shzhhw-lgtm/HINK-5.83EPD/bigclock/IMG_20261107_204027.jpg

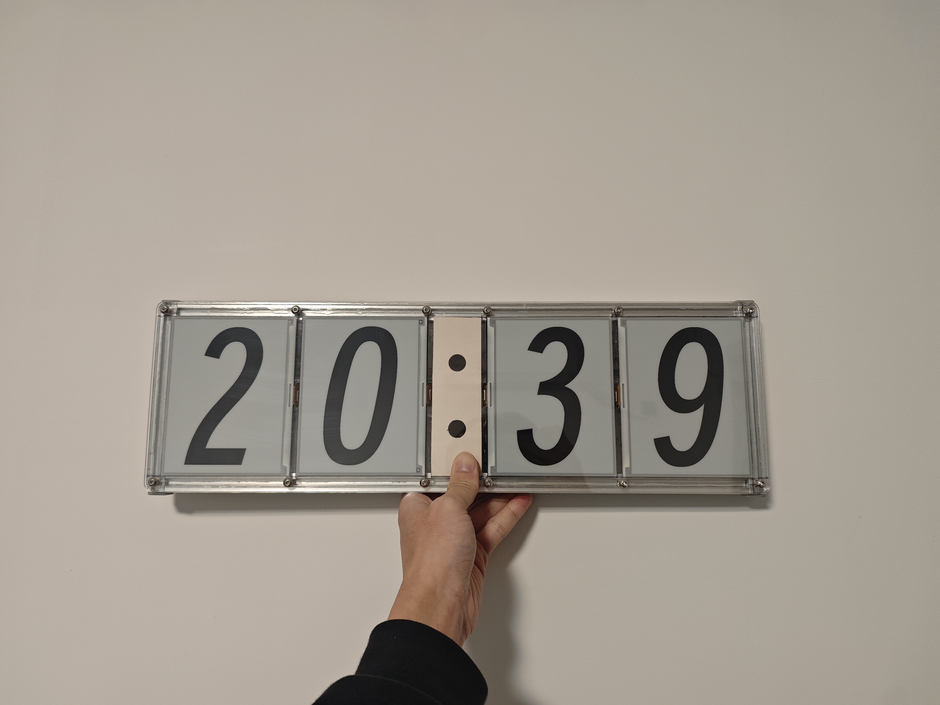
bigclock/IMG_20261107_204027.jpg
