shzhhw-lgtm/HINK-5.83EPD/UC8179_EPD/PARAMETERS.md

# UC8179 可调参数总表（基于 UC8179 手册 + 本屏 OTP）

> 配合 `examples/04_ParamLab` 使用。所有参数都能在运行时改，不需要重烧 OTP。
> 表格里的“OTP 默认”是 `src/UC8179_PanelProfile.h` 里这份 OTP 的值。

---

## 1. 一句话结论

**能改的**：波形档 TR0~TR7、VCOM_DC、VDH/VDL/VDHR、VGH/VGL、帧率、CDI、TCON、
EVS、BTST、PWS、LVSEL、温度偏移、单/双平面、方向、边框 LUT。

**不能改的**：OTP 里烧死的波形表本身（可以整体选哪一档，或整体换成寄存器 LUT），
面板玻璃的极性，OTP 内容（一次性的）。

---

## 2. TR 波形档（最值得先测）

芯片在每次刷新时按温度从 OTP 里选 TR0~TR7。用 `TSFIX=1 + TSSET` 可以强制选任意一档：

| 档位 | 强制温度码 | 适用温度 | 帧率 | VDH/VDL | VCOM_DC | VGH/VGL | 备注 |
|---|---:|---|---:|---|---|---|---|
| TR0 | `0x05` | ≤5°C | 50Hz | ±15.0V | -1.00V | ±20V | 冷 |
| TR1 | `0x0A` | ≤10°C | 50Hz | ±15.0V | -1.00V | ±20V | |
| TR2 | `0x0F` | ≤15°C | 50Hz | ±15.0V | -1.00V | ±20V | |
| TR3 | `0x14` | ≤20°C | 50Hz | ±15.0V | -1.00V | ±20V | |
| TR4 | `0x1E` | ≤30°C | **60Hz** | ±15.0V | -1.00V | ±20V | 常用快速档 |
| TR5 | `0x50` | ≤80°C | **70Hz** | ±15.0V | -1.00V | ±20V | 最快 |
| TR6 | `0x5A` | ≤90°C | 50Hz | ±15.0V | **-2.00V** | ±20V | KWE=0x0A6 |
| TR7 | `0x7F` | ≤127°C | 50Hz | ±15.0V | **-2.00V** | ±20V | 常用高质量档 |

API：

```cpp
epd.setWaveformGear(0..7);     // 直接选 TR0~TR7
epd.setTemperatureForce(0x1E); // 原始 TSSET
epd.setTemperatureAuto();      // 取消强制，回到自动分档
epd.setRefreshMode(UC8179_EPD::REFRESH_QUALITY); // = TR7
```

> TR6/TR7 的 VCOM 是 -2.0V，所以换档时对比度会跟着变，这是 OTP 设计好的，不是 bug。
> 测的时候要连同 VCOM 一起看。

---

## 3. 全部可调寄存器

| 参数 | 命令/寄存器 | 位 | 取值范围 | OTP 默认 | 影响 | 风险 |
|---|---|---|---|---|---|---|
| LUT 来源 | PSR `0x00` | D5 | 0=OTP，1=寄存器 | 0 | 改 1 必须自己写全套 LUT | 高：不写 LUT 会白屏 |
| KW/KWR | PSR | D4 | 1=KW 黑白 | 1 | 本屏必须 1 | 高：改 0 变三色模式 |
| 扫描方向 | PSR | D3 | 0/1 | 0（库改 1） | 上下翻转 | 低 |
| 移位方向 | PSR | D2 | 0/1 | 1 | 左右镜像 | 低 |
| Booster 开关 | PSR | D1 | 1=开 | 1 | 关掉就断电 | 中 |
| 软复位 | PSR | D0 | 0=复位 | 1 | 不要手动置 0 | 高 |
| VGH/VGL | PWR `0x01` | byte2[2:0] | 0..7 = 9/10/11/12/17/18/19/20V | 7（±20V） | 栅压，影响速度/残影 | 中：越低越慢 |
| VDH | PWR | byte3[5:0] | 0..63 = 2.4..15.0V（0.2V/步） | 0x3F=15.0V | 正源压，影响黑度 | 中 |
| VDL | PWR | byte4[5:0] | 0..63 = -2.4..-15.0V | 0x3F=-15.0V | 负源压 | 中 |
| VDHR | PWR | byte5[5:0] | 0..63 | 0x12=6.0V | KW 模式基本不用 | 低 |
| 软启动 A/B/C1/C2 | BTST `0x06` | 4 字节 | 见手册 | `CF CF 26 17` | 上电浪涌/稳定性 | 中 |
| 帧率 | PLL `0x30` | [3:0] | 0..15 = 5..200Hz | 6（50Hz） | 刷新速度/闪烁 | 低 |
| 边框 Hi-Z | CDI `0x50` | D7 | 0/1 | 0 | 边框电平 | 低 |
| 边框 LUT | CDI | D5:4 | 0=LUTBD 1=LUTKW 2=LUTWK 3=LUTKK | 1 | 边框亮暗 | 低 |
| NEW→OLD 复制 | CDI | D3 | 0/1 | 0 | 局刷用 | 低 |
| 单/双平面 | CDI | D1:0 | 10=单平面，00=双平面 | 0（库改 10） | 数据量/波形路径 | 中 |
| CDI 间隔 | CDI | 第二字节[3:0] | 2..17 hsync | 7（10 hsync） | VCOM 与数据时序 | 中 |
| 栅源非交叠 | TCON `0x60` | 8 位 | 4..64 × 667ns | 0x22 | 拖影/串扰 | 中 |
| 边框结束电平 | EVS `0x52` | D3,D1:0 | VCEND 0/1；BDEND 0..3 | 0x02 | 刷完边框电压 | 低 |
| VCOM_DC | VDCS `0x82` | [6:0] | 0..79 = -0.10..-4.05V（0.05V/步） | TR0: 0x12=-1.00V | 对比度/残影 | 中：过负会脏 |
| 省电宽度 | PWS `0xE3` | [7:4],[3:0] | 0..15 | 0x88 | 电压翻转省电 | 低 |
| 低压检测 | LVSEL `0xE4` | [1:0] | 0..3 = 2.2..2.5V | 3 | 电池检测阈值 | 低 |
| 温度偏移 | TSE `0x41` | [3:0] | -8..+7°C | 0 | **平移自动 TR 分档** | 低 |
| 强制温度 | CCSET/TSSET | — | 0..127 | 关 | 选 TR 档 | 低 |

> 所有电压码都是 6 位，VDH/VDL 最大只能到 ±15.0V，硬件上超不了手册的 16V 上限。

---

## 4. 建议的测试顺序

0. **先跑 `P` 可控性探测**：确认 VCOM/VDH/FRS/CDI/TCON 到底有没有用，再谈调参。
1. **TR0~TR5**（`S` 自动扫）：同一张图看黑度、白度、1px 线条、残影，记录 `refresh ms`。
   `Z` 可扫 TR6~TR7，但那两档是 80~127°C 的高温波形，只作实验。
2. 选一个综合最好的档（通常 TR4 快、TR7 稳），固定住。
3. **VCOM**（`+`/`-` 或 `v0x12`）：每步 0.05V，找“黑够黑、白够白、残影最少”的点。
4. **VDH/VDL**（`h`/`l`）：在 0x39~0x3F 之间试，看黑度和拖影。
5. **CDI 间隔**（`c`）：3~12 之间扫，看边缘/拖影。
6. **TCON**（`setTcon()`）：0x11~0x33，看细线串扰。
7. **FRS**（`f`）：先验证它是否被 TR 覆盖（改完看刷新时间有没有变）。
8. **BDV/EVS**：只影响边框，最后调。
9. **BTST/PWS**：只在出现上电花屏/电流异常时再动。

每次改完按 `p`，串口会打印一行完整参数，直接抄进记录表。

---

## 5. 记录表模板

| 日期 | TR | VCOM | VDH/VDL | FRS | CDI | TCON | 黑度 | 白度 | 1px线 | 残影 | refresh(ms) | 备注 |
|---|---|---|---:|---:|---:|---|---|---|---|---|---:|---|
| | 4 | 0x12 | 3F/3F | 6 | 7 | 22 | | | | | | 基线 |
| | 7 | 0x12 | 3F/3F | 6 | 7 | 22 | | | | | | |
| | 4 | 0x10 | 3F/3F | 6 | 7 | 22 | | | | | | VCOM -0.9V |

---

## 6. 两个需要实测确认的点

UC8179 手册没有明确写死、只能实测的地方：

1. **VDCS 和 OTP TR 里的 VCOM_DC 谁优先？**
   TR6/TR7 自带 -2.0V，如果你又写 `setVcomDc(0x12)`（-1.0V），最终用哪个？
   用 `t6` 后改 `v` 观察对比度是否变化即可判断。
2. **PLL 的 FRS 会不会被 TR 里的帧率覆盖？**
   改 `f` 后看 `refresh ms` 是否变化；不变就说明 TR 覆盖了它。

---

## 7. 回读能拿到什么

接上回读（`begin` 的 `miso`）后，这些不用猜：

| 命令 | 内容 | API |
|---|---|---|
| 0x70 REV | 生产版本 3B / LUT 版本 3B / 芯片版本（固定 0x0C） | `readRevision()`、`lutRevision()`、`chipRevision()` |
| 0x71 FLG | BUSY_N / POF / PON / Data_Flag | `readStatus()` |
| 0x40 TSC | 内部温度传感器（°C） | `readTemperature()` |
| 0x81 VV | VCOM 实测码 | `readVcom()` |
| 0x44 PBC | 面板 ITO 断线检查 | `panelCheck()` |
| 0xA2 ROTP | OTP 原始数据（从 0x000 顺序读） | `readOtp()`、`readOtpBlock()`、`loadOtpProfile()` |

`currentTrGear()` 会把温度和 TSE 偏移一起算进去，直接告诉你现在落在 TR0~TR7 哪一档。\n`loadOtpProfile()` 会把 0x000~0x04F 解析成 PSR/CDI/TCON/BTST/HST/VST/TR0 电压并直接套用；\n`begin()` 在回读可用时自动执行。换引脚调试用 `setReadPin()`。

---

## 8. 还没做的（进阶）

- **寄存器 LUT**（PSR.REG=1 + `0x20~0x25`）：可以完全自定义波形，但要按
  61/43 字节的格式写 LUTC/LUTWW/LUTKW/LUTWK/LUTKK/Border，工作量大且容易伤屏。
- **局部刷新**（PTL `0x90` + PTIN/PTOUT）：OTP 没有专用局刷波形，当前不建议。
- **OTP 读取**：`0xA2` 读 OTP 需要 SDA 同时接 MISO，当前库只写不读。
