shzhhw-lgtm/HINK-5.83EPD/bigclock/时钟外壳/其他材料.pdf

其他材料 | 规格 | 数量 | 参考图片

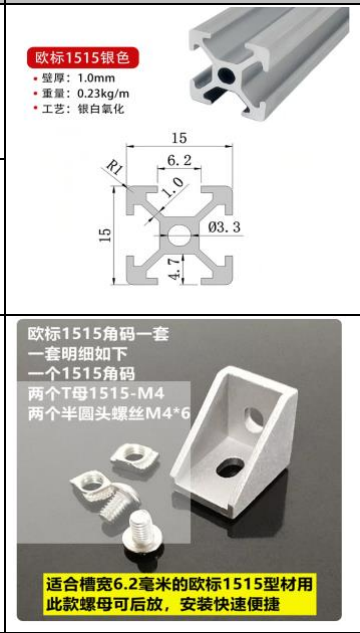
[picture p2: figure]

1515欧标铝型材 | 450mm | 2
| 150mm | 2
配套角码 (2个螺丝+2个T螺 母+1角码) | 一般店内有对应型号 | 4
15TM4 | 一般店内有对应型号 | 12

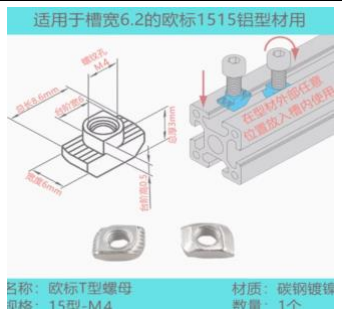
[picture p3: figure]

M4内六角 | M4x12 | 若干 | /

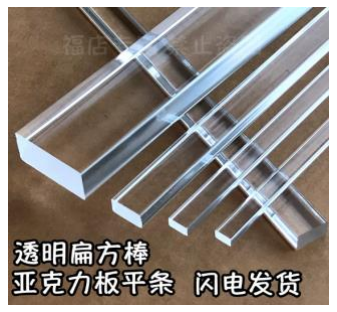
[picture p4: figure]

亚克力棒 | 2mm x 4mm (长度足够即可) | /

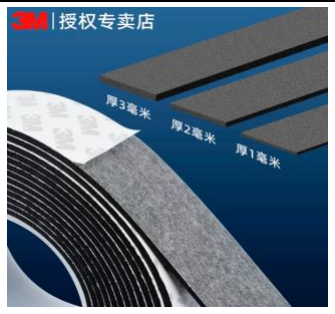
[picture p5: figure]

3M单面EVA泡棉胶 | 宽1厘米*厚1mm | /

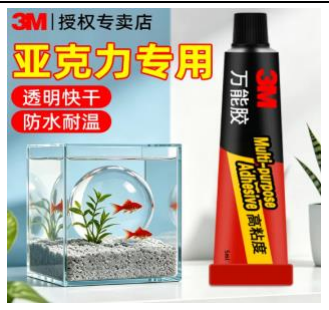
[picture p6: figure]

3M-AD605 亚克力胶水 | / | /
