shzhhw-lgtm/HINK-5.83EPD/bigclock/时钟外壳/保护面板(长480宽150)-单位毫米.pdf

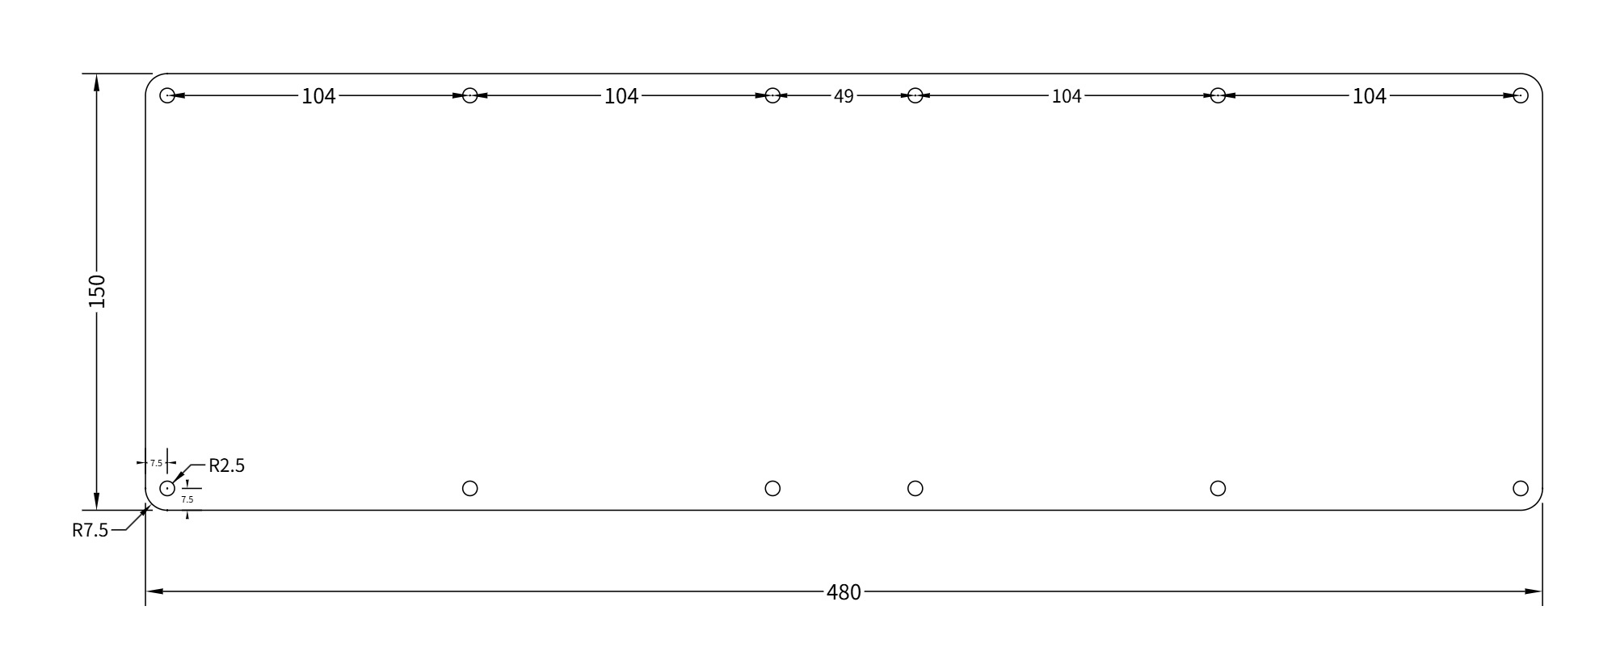
[picture p7: page 1]
