shzhhw-lgtm/HINK-5.83EPD/bigclock/时钟外壳/背板(长480宽150)-单位毫米.pdf

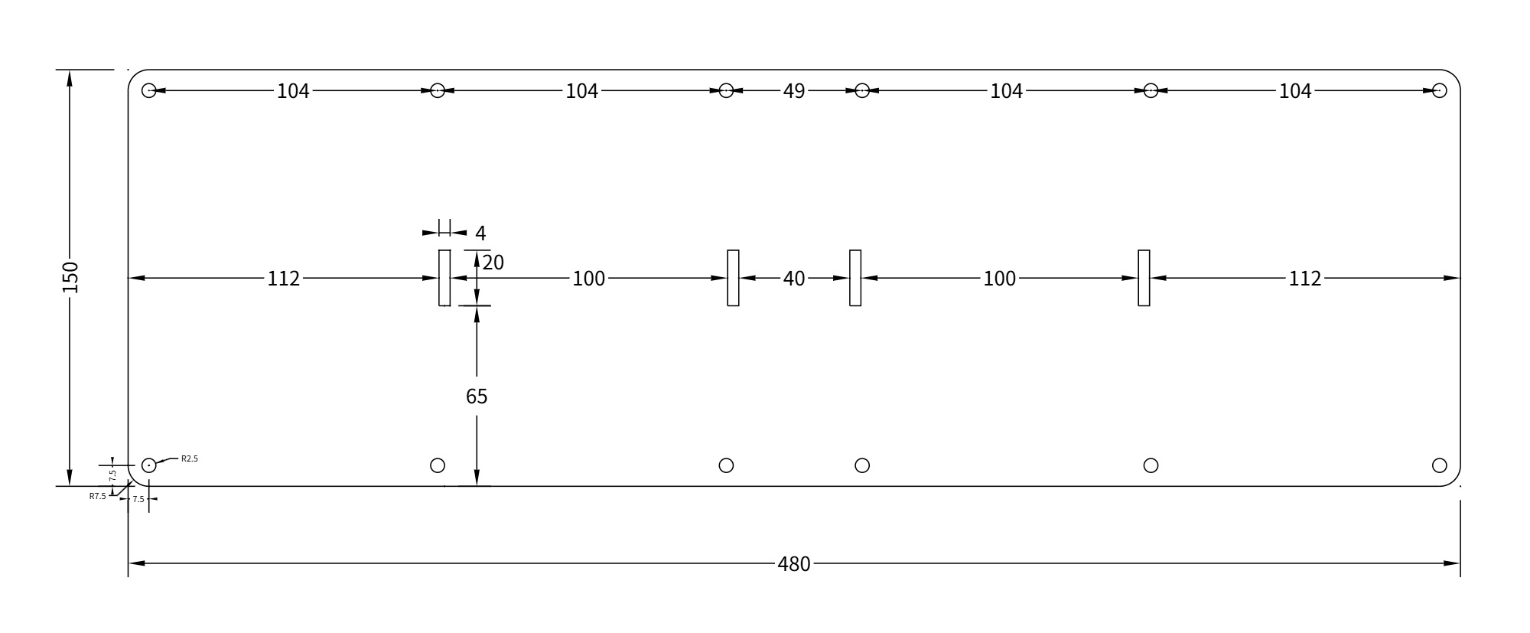
[picture p8: page 1]
