shzhhw-lgtm/HINK-5.83EPD/bigclock/datasheet/接线图.PNG

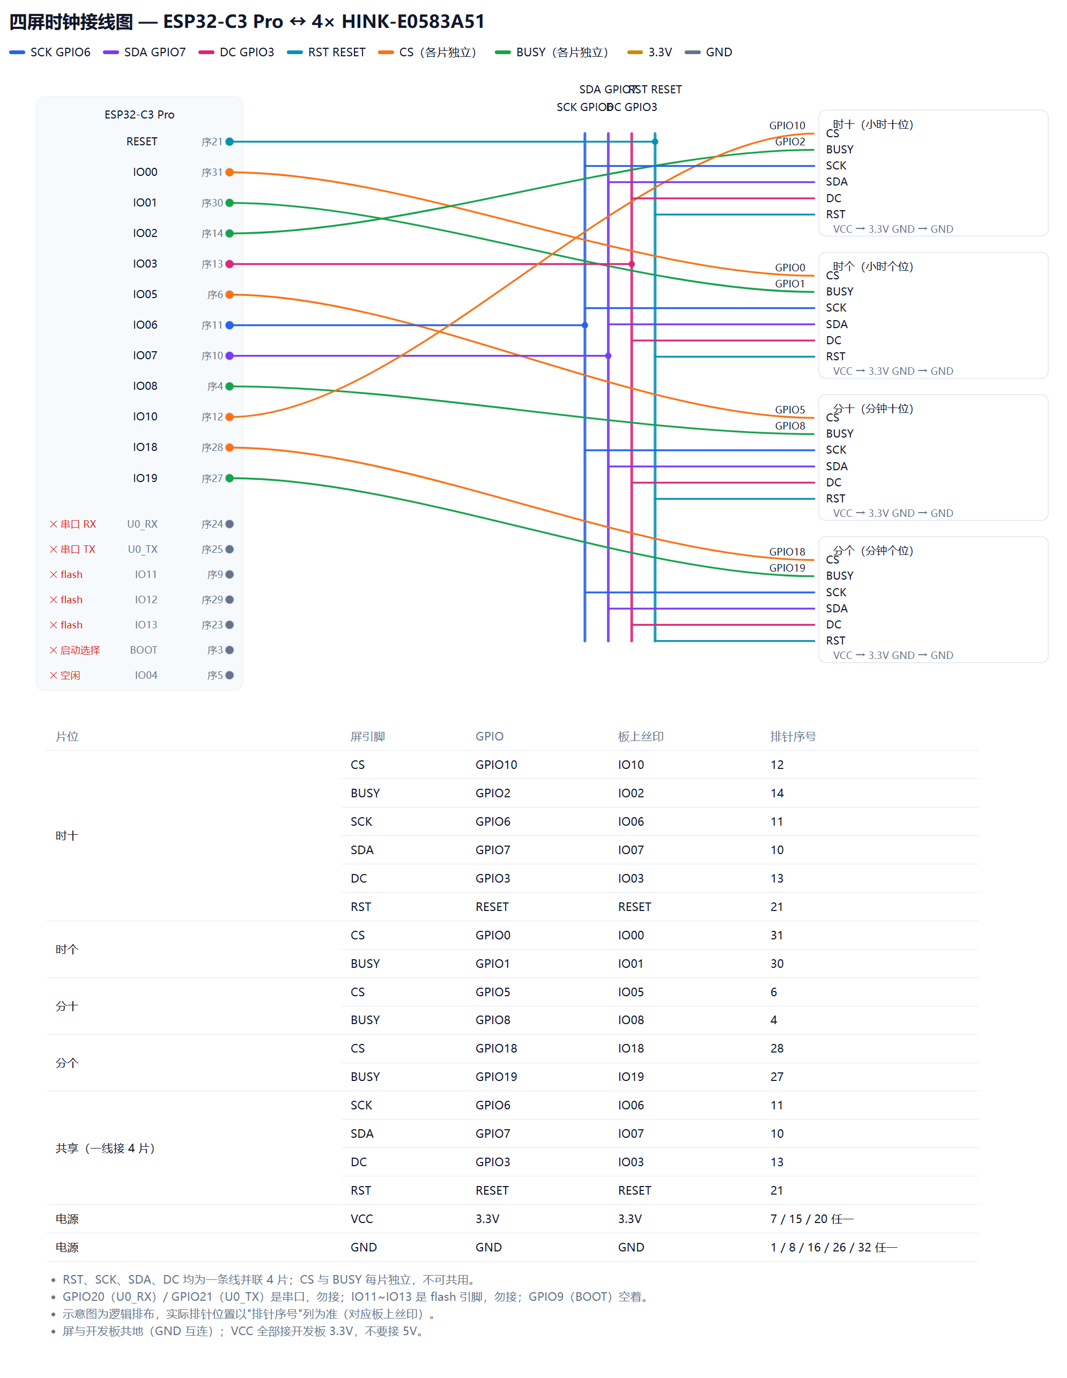
bigclock/datasheet/接线图.PNG
