shzhhw-lgtm/HINK-5.83EPD/bigclock/时钟外壳/背板(长480宽150)-单位毫米.dxf

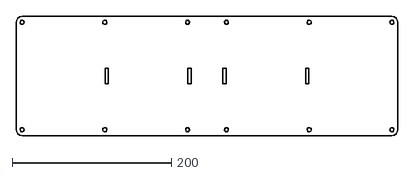
[picture p10: CAD file, 2026-11-10]
bigclock/时钟外壳/背板(长480宽150)-单位毫米.dxf
480.0 x 150.0
