shzhhw-lgtm/HINK-5.83EPD/UC8179_EPD/src/UC8179_Font7x8.h

// 7x8 ASCII 点阵字体 (0x20~0x7E)，由 tools/make_font7x8.py 生成
// 每个字符 8 字节，按行存储；bit6 = 最左列（共 7 列），bit7 恒为 0
// 字形来源: Consolas Bold，经 3x3 超采样二值化
#pragma once
#include <Arduino.h>

#define UC8179_FONT_W 7
#define UC8179_FONT_H 8

static const uint8_t UC8179_FONT7X8[95][8] PROGMEM = {
  {0x00,0x00,0x00,0x00,0x00,0x00,0x00,0x00}, // 0x20 'space'
  {0x10,0x10,0x10,0x10,0x10,0x00,0x10,0x00}, // 0x21 '!'
  {0x28,0x28,0x28,0x00,0x00,0x00,0x00,0x00}, // 0x22 '"'
  {0x00,0x24,0x3C,0x3C,0x28,0x7C,0x28,0x00}, // 0x23 '#'
  {0x08,0x38,0x30,0x30,0x1C,0x14,0x7C,0x10}, // 0x24 '$'
  {0x20,0x54,0x78,0x10,0x1C,0x2C,0x2C,0x00}, // 0x25 '%'
  {0x10,0x28,0x28,0x30,0x34,0x4C,0x7C,0x00}, // 0x26 '&'
  {0x10,0x10,0x10,0x00,0x00,0x00,0x00,0x00}, // 0x27 '\''
  {0x08,0x18,0x10,0x30,0x30,0x30,0x10,0x10}, // 0x28 '('
  {0x20,0x10,0x18,0x08,0x08,0x08,0x08,0x10}, // 0x29 ')'
  {0x00,0x3C,0x38,0x3C,0x00,0x00,0x00,0x00}, // 0x2A '*'
  {0x00,0x00,0x10,0x10,0x7C,0x10,0x10,0x00}, // 0x2B '+'
  {0x00,0x00,0x00,0x00,0x00,0x10,0x18,0x18}, // 0x2C ','
  {0x00,0x00,0x00,0x00,0x38,0x00,0x00,0x00}, // 0x2D '-'
  {0x00,0x00,0x00,0x00,0x00,0x10,0x18,0x00}, // 0x2E '.'
  {0x04,0x08,0x08,0x18,0x10,0x10,0x20,0x20}, // 0x2F '/'
  {0x00,0x38,0x24,0x6C,0x74,0x64,0x3C,0x00}, // 0x30 '0'
  {0x00,0x18,0x38,0x18,0x18,0x18,0x3C,0x00}, // 0x31 '1'
  {0x00,0x38,0x0C,0x0C,0x08,0x10,0x3C,0x00}, // 0x32 '2'
  {0x00,0x38,0x0C,0x08,0x1C,0x04,0x3C,0x00}, // 0x33 '3'
  {0x00,0x18,0x18,0x28,0x28,0x7C,0x08,0x00}, // 0x34 '4'
  {0x00,0x3C,0x20,0x38,0x0C,0x04,0x38,0x00}, // 0x35 '5'
  {0x00,0x1C,0x20,0x38,0x6C,0x24,0x3C,0x00}, // 0x36 '6'
  {0x00,0x3C,0x0C,0x08,0x18,0x10,0x30,0x00}, // 0x37 '7'
  {0x00,0x38,0x24,0x38,0x38,0x24,0x3C,0x00}, // 0x38 '8'
  {0x00,0x38,0x6C,0x64,0x3C,0x0C,0x38,0x00}, // 0x39 '9'
  {0x00,0x00,0x10,0x10,0x00,0x00,0x18,0x00}, // 0x3A ':'
  {0x00,0x00,0x10,0x10,0x00,0x10,0x18,0x18}, // 0x3B ';'
  {0x00,0x00,0x08,0x10,0x20,0x10,0x08,0x00}, // 0x3C '<'
  {0x00,0x00,0x00,0x3C,0x00,0x3C,0x00,0x00}, // 0x3D '='
  {0x00,0x00,0x30,0x18,0x0C,0x18,0x30,0x00}, // 0x3E '>'
  {0x10,0x08,0x0C,0x18,0x10,0x00,0x10,0x00}, // 0x3F '?'
  {0x18,0x34,0x24,0x7C,0x6C,0x7C,0x5C,0x40}, // 0x40 '@'
  {0x00,0x18,0x38,0x28,0x2C,0x3C,0x44,0x00}, // 0x41 'A'
  {0x00,0x38,0x2C,0x2C,0x3C,0x24,0x3C,0x00}, // 0x42 'B'
  {0x00,0x1C,0x20,0x60,0x60,0x20,0x3C,0x00}, // 0x43 'C'
  {0x00,0x78,0x6C,0x64,0x64,0x64,0x78,0x00}, // 0x44 'D'
  {0x00,0x3C,0x20,0x20,0x38,0x20,0x38,0x00}, // 0x45 'E'
  {0x00,0x3C,0x20,0x20,0x38,0x20,0x20,0x00}, // 0x46 'F'
  {0x00,0x1C,0x20,0x60,0x6C,0x64,0x3C,0x00}, // 0x47 'G'
  {0x00,0x64,0x64,0x64,0x7C,0x64,0x64,0x00}, // 0x48 'H'
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
};
