shzhhw-lgtm/HINK-5.83EPD/(commit log)

2026-11-05 清屏示例
2026-11-10 Delete uc8179_otp_parser.py
    精简目录
2026-11-10 增加时钟diy项目
    [保护面板(长480宽150)-单位毫米.dxf, 背板(长480宽150)-单位毫米.dxf]
